Traorehub/Federated_Learning_station_meteo/docs/ARCHITECTURE.md

# Architecture : POC 2 nœuds

## Périmètre actuel

**v1** : dashboard comms ([rapport](v1/V1_Rapport.md)). **v2** : poids locaux en LoRa ([rapport](v2/V2_Rapport.md)). **v3** : FedAvg ([rapport](v3/V3_Rapport.md)).

```
ESP32 + DHT11 + RA-02  --LoRa 433 MHz-->  Arduino Uno + RA-02
                                              |
                                         USB série 115200
                                              |
                                      Agent PC (poste de labo)
                                              |
                                      HTTPS POST /api/ingest
                                              v
                    API + PostgreSQL + dashboard
                    (Docker local ou VPS personnel)
```

L’Arduino est branché en USB sur le **PC**, pas sur le serveur.
L’agent local lit le port série et transmet vers l’API (locale ou distante).
C’est volontaire : le backend et le frontend restent sur le serveur déployé
par l’expérimentateur, le lien radio reste au laboratoire.

Il n’existe pas d’instance publique maintenue en continu. Chacun déploie
son propre serveur et peut l’arrêter à tout moment.

## Capture vs entraînement (cycle réel d’un nœud)

La capture et l’entraînement ne sont pas simultanés. Ce n’est pas non plus un schéma où l’on accumule d’abord toutes les données, puis on entraîne une seule fois.

1. Le nœud **capte en continu**, en tâche de fond, à intervalle fixe
   (DHT11 toutes les 15 s dans ce POC, plage cible 10-30 s).
   Cette capture est indépendante de tout entraînement. Les mesures sont
   stockées dans un tampon local.
2. L’**entraînement se déclenche par round**, pas en continu :
   - soit un critère local (assez de nouvelles données pour s’entraîner) ;
   - soit un signal du serveur (tous les nœuds s’entraînent maintenant).

La v1 n’implémente que (1) : capter, envoyer, stocker, afficher.
La v2 ajoute le tampon, le SGD local et l’envoi des poids en LoRa.
La v3 agrège (FedAvg) et renvoie $w_{\text{global}}$ en downlink LoRa.

## Décision méthodologique : synchrone vs asynchrone

| Mode | Qui déclenche le round | Intérêt | Coût |
|---|---|---|---|
| **Synchrone (FedAvg classique)** | Le serveur envoie `start round` | Timing contrôlé, débogage plus simple | Les nœuds attendent un signal centralisé |
| **Asynchrone** | Chaque nœud selon son tampon / sa radio | Plus réaliste pour un FL décentralisé | Plus difficile à déboguer |

**Choix du POC à 2 nœuds : synchrone, piloté par le serveur.**

Justification : FedAvg classique, reproductible, timing maîtrisé.
L’asynchrone est plus fidèle à la thèse finale (dans un FL vraiment
décentralisé, les nœuds n’attendent pas un orchestrateur). Il viendra
après, une fois la chaîne radio et le dashboard v1 stables.

Cette décision est **documentée** pour la thèse. Le firmware écoute `start_round` et le modèle global ; le serveur clôt le round et calcule $w_{\text{global}}$.

**Nuance apportée par la mesure.** Le mode est synchrone dans son intention, pas dans son effet : la [v4](v4/V4_Rapport.md) montre que les poids n’arrivent jamais en réponse immédiate au `start_round`, mais toujours au créneau d’émission périodique du nœud, une fois par minute. Le serveur **ouvre** donc le round ; ce sont les horloges des nœuds qui déterminent sa clôture. Le banc est en pratique à mi-chemin entre les deux modes du tableau, et la fenêtre de timeout ne tolère de ce fait aucune perte de paquet.

## Versions (ne pas fusionner les dashboards)

| Version | Objectif | Statut |
|---|---|---|
| **v1** | Communications : temp, hum, RSSI, SNR, seq, âge | **Faite** |
| **v2** | Poids locaux sur LoRa, canal témoin / dégradé | **Faite** |
| **v3** | FedAvg : moyenne + modèle global, UI rounds, erreur de prédiction mesurée, contrôle par échange des rôles | **Faite** |
| **v4** | Historique du taux de réception, du RSSI et de la latence (vue `#reseau`) | **Faite** ([rapport](v4/V4_Rapport.md)) |
| **v5** | Tolérance du timeout 90 / 120 / 150 s | **Faite** ([rapport](v5/V5_Rapport.md)) |

Les métriques de liaison (RSSI, SNR, trous de séquence) remontent **dès la v1**
pour ne pas refaire le schéma plus tard. La v4 les historise finement, et retient
le **taux de réception** en priorité, le RSSI moyen s’étant révélé aveugle à la
dégradation par biais du survivant (voir [session d’inversion](v3/V3_Session_inversion.md)).

## Ce que le serveur calcule déjà (v1)

Le serveur ne se limite pas au stockage :

- **RSSI / SNR** du dernier paquet (qualité instantanée du lien LoRa)
- **Compteur de séquence** : détection des paquets manquants
- **Taux de perte** = `missing / (received + missing)`
- **Paquets corrompus** (checksum LoRa invalide)
- **Âge** = maintenant - `last_seen_at`

Depuis la v3, il évalue aussi la **qualité des modèles** (`/api/fl/errors`) : RMSE du modèle
global et des modèles locaux sur les lectures postérieures à la clôture du round, avec la
persistance comme référence. Ce calcul est fait à la demande, pas au moment de la clôture :
la vérité terrain n'existe pas encore quand le round se ferme.

## Hors périmètre de ce banc

- Agrégation FedAvg asynchrone
- Variation du spreading factor
- Plus de deux nœuds
- MQTT
- Dashboard rounds fusionné avec les cartes radio v1
