Traorehub/Federated_Learning_station_meteo/docs/capture_serialmonitore_gateway.png

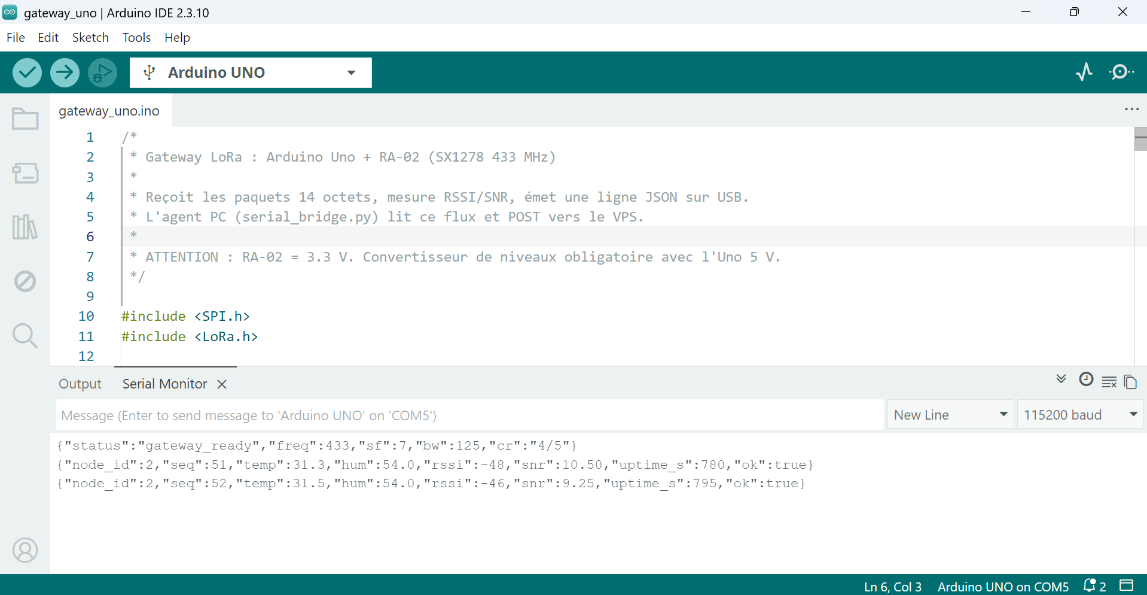
docs/capture_serialmonitore_gateway.png
