Traorehub/Federated_Learning_station_meteo/docs/Screenshot_du_graphe_des_qui_est otutenbasavecmodelegloabparround.png

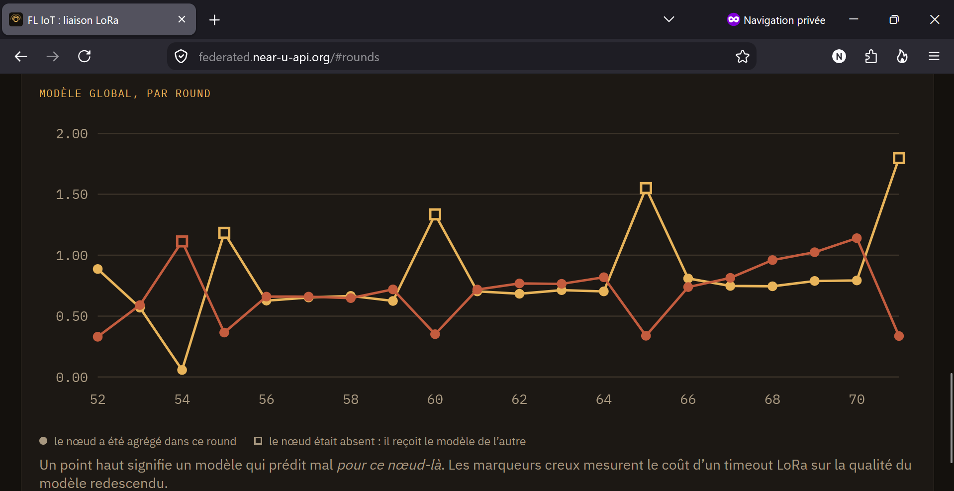
docs/Screenshot_du_graphe_des_qui_est otutenbasavecmodelegloabparround.png
