Traorehub/Federated_Learning_station_meteo/results/campagne-2026-08-27-complete/fl_updates.csv

id | node_id | seq | n_samples | round_id | w0 | w1 | w2 | w3 | rssi | snr | checksum_ok | received_at
1 | 1 | 28 | 28 | 0 | 0.612954 | 0.312854 | 0.016257 | 0.026604 | -66 | 10.25 | t | 2026-08-27 18:34:39.876218+00
2 | 2 | 4 | 4 | 0 | 0.646324 | 0.287155 | 0.043157 | 0.079921 | -35 | 9.5 | t | 2026-08-27 18:35:36.257738+00
3 | 1 | 32 | 32 | 0 | 0.612949 | 0.312842 | 0.016272 | 0.026611 | -68 | 9.25 | t | 2026-08-27 18:35:39.879854+00
4 | 2 | 8 | 8 | 0 | 0.64622 | 0.199818 | 0.04234 | 0.078073 | -34 | 9.75 | t | 2026-08-27 18:36:36.1686+00
5 | 1 | 36 | 32 | 0 | 0.612951 | 0.312845 | 0.016265 | 0.026618 | -66 | 10 | t | 2026-08-27 18:36:39.787419+00
6 | 1 | 40 | 32 | 0 | 0.612957 | 0.312851 | 0.016253 | 0.026632 | -66 | 9.75 | t | 2026-08-27 18:37:39.842792+00
7 | 2 | 16 | 16 | 0 | 0.662672 | 0.097352 | 0.057942 | 0.105869 | -102 | -3 | t | 2026-08-27 18:38:36.16435+00
8 | 1 | 44 | 32 | 0 | 0.612963 | 0.312857 | 0.016252 | 0.026652 | -66 | 9.75 | t | 2026-08-27 18:38:39.755221+00
9 | 2 | 20 | 20 | 0 | 0.667551 | 0.070161 | 0.062981 | 0.114839 | -102 | -3.25 | t | 2026-08-27 18:39:36.181727+00
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
