Traorehub/Federated_Learning_station_meteo/results/campagne-2026-08-27-complete/readings.csv

id | node_id | seq | temperature | humidity | rssi | snr | uptime_s | checksum_ok | error | received_at
1 | 2 | 0 | 0.6 | 0 | -41 | 9.25 | 15 | t |  | 2026-08-24 17:28:21.684877+00
2 | 2 | 1 | 30.2 | 55 | -39 | 9.25 | 30 | t |  | 2026-08-24 17:28:36.687329+00
3 | 2 | 2 | 30.7 | 55 | -38 | 9.5 | 45 | t |  | 2026-08-24 17:28:51.684885+00
4 | 2 | 3 | 30 | 55 | -40 | 10 | 60 | t |  | 2026-08-24 17:29:06.683542+00
5 | 2 | 4 | 30.7 | 55 | -37 | 9.75 | 75 | t |  | 2026-08-24 17:29:21.682537+00
6 | 2 | 5 | 30.5 | 55 | -39 | 9.5 | 90 | t |  | 2026-08-24 17:29:36.684189+00
7 | 2 | 6 | 30 | 55 | -37 | 9.5 | 105 | t |  | 2026-08-24 17:29:51.681996+00
8 | 2 | 7 | 30.4 | 55 | -36 | 9.5 | 120 | t |  | 2026-08-24 17:30:06.681036+00
9 | 2 | 9 | 30.8 | 55 | -39 | 9 | 150 | t |  | 2026-08-24 17:30:36.681016+00
10 | 2 | 10 | 30.7 | 55 | -38 | 9.5 | 165 | t |  | 2026-08-24 17:30:51.681525+00
11 | 2 | 11 | 30.7 | 55 | -37 | 9.75 | 180 | t |  | 2026-08-24 17:31:06.680475+00
12 | 2 | 12 | 30.9 | 55 | -44 | 9 | 195 | t |  | 2026-08-24 17:31:21.679127+00
13 | 2 | 14 | 30.6 | 55 | -40 | 9.5 | 225 | t |  | 2026-08-24 17:31:51.679448+00
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
