Traorehub/Federated_Learning_station_meteo/(commit log)

2026-08-31 v1.5 avec les analyses des premiers resultat
2026-09-03 transfert des poind avec les paquets lora terminés
    [fl_updates.csv, node_stats.csv, node_stats_avant_reset.csv, readings.csv, resume_fl_updates.csv, resume_par_jour.csv, resume_readings.csv, seq_span.csv]
2026-09-05 fedAvg terminé
    [fl_rounds.csv, fl_updates.csv, node_stats.csv]
2026-09-05 correction pour plus de data de lancement de round
    [readings.csv]
2026-09-06 version 5 terminé
    [fl_rounds.csv, fl_updates.csv, latence.csv, node_stats.csv, readings.csv]
