Traorehub/Federated_Learning_station_meteo/(notices)

Notices in the files:
README.md:
License: MIT
